avem-labs/Avem/docs/images/FinalVersion.JPG

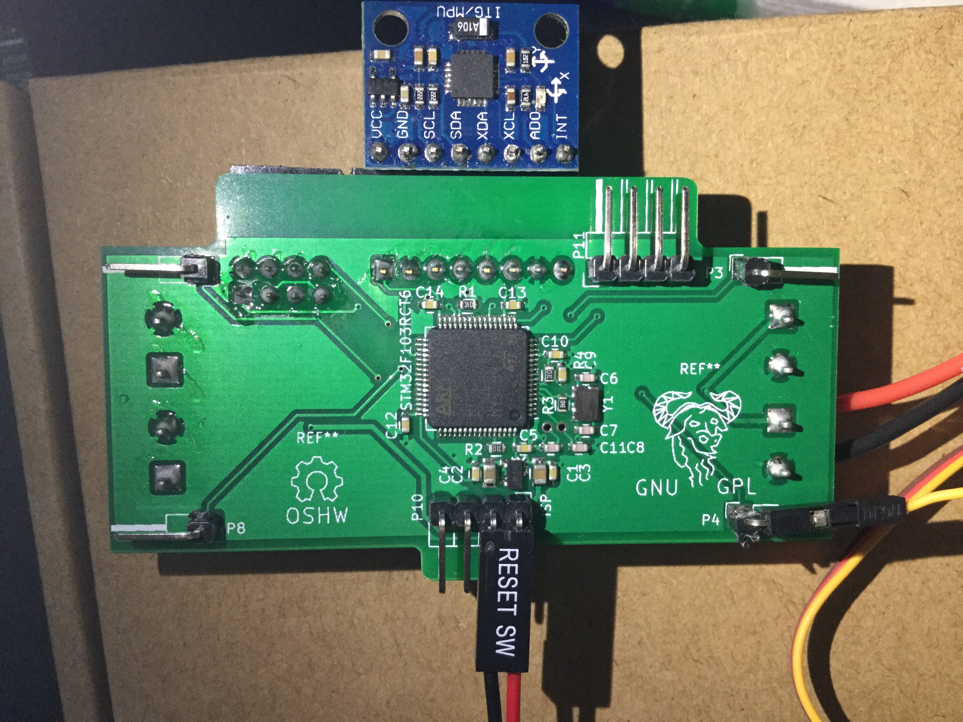
docs/images/FinalVersion.JPG
