avem-labs/Avem/docs/images/PCB/demoV1.0.jpg

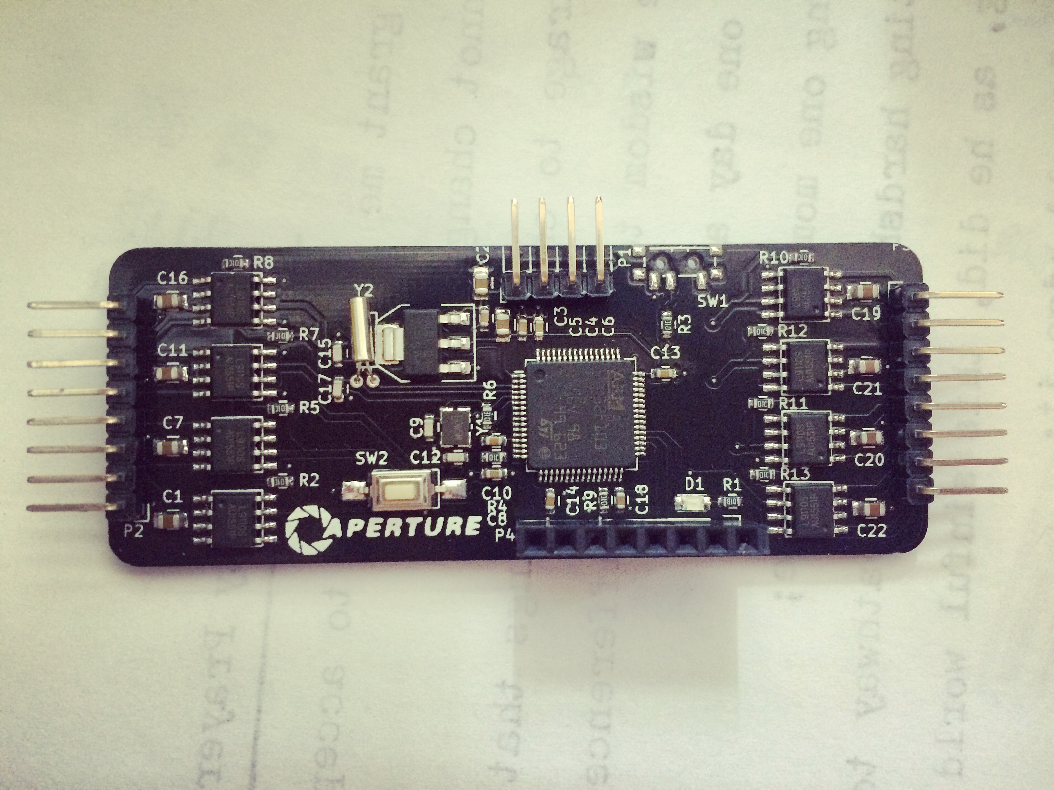
docs/images/PCB/demoV1.0.jpg
