avem-labs/Avem/docs/images/PCB/demoV2.0.JPG

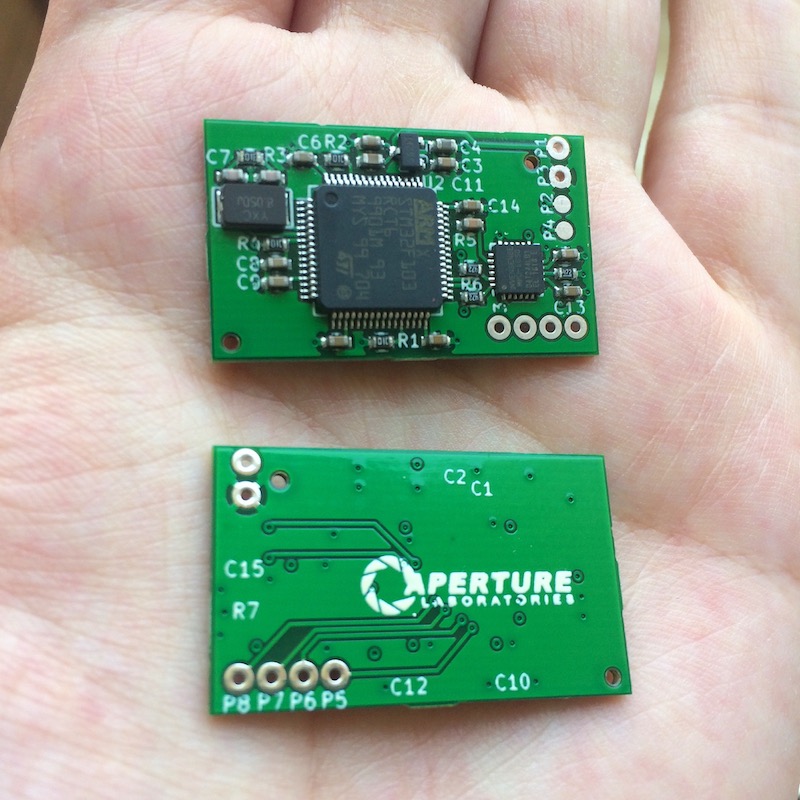
docs/images/PCB/demoV2.0.JPG
