avem-labs/Avem/docs/images/PCB/demoV2.0_PCB.JPG

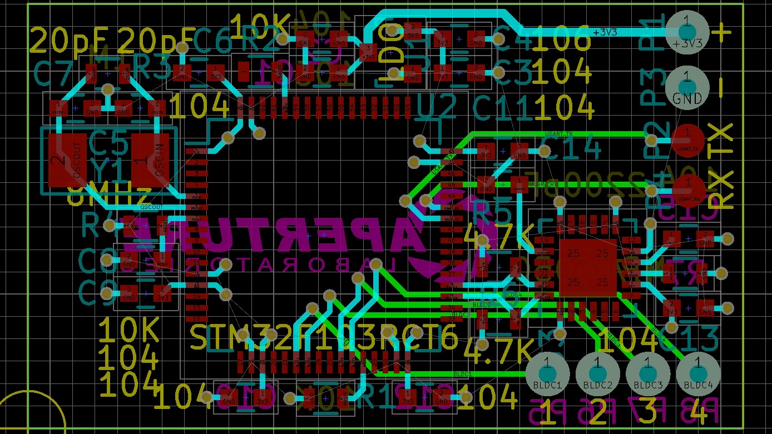
docs/images/PCB/demoV2.0_PCB.JPG
