avem-labs/Avem/docs/images/PCB/demoV2.png

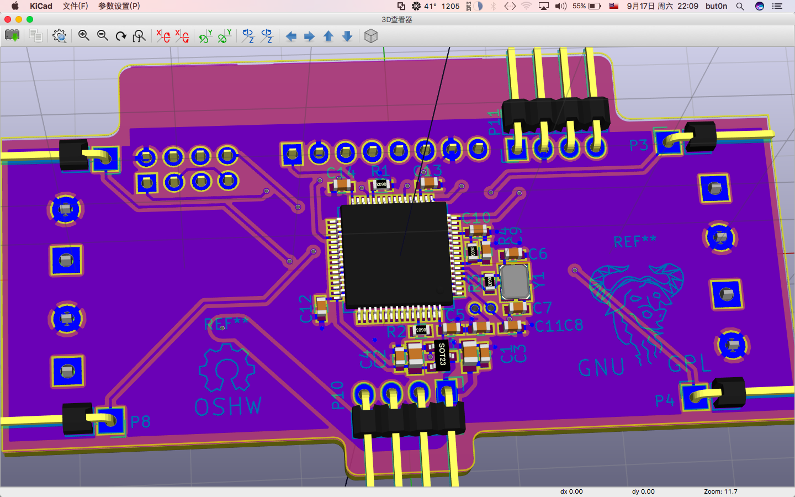
docs/images/PCB/demoV2.png
