avem-labs/Avem/docs/images/PCB/demoV3.0_top.JPG

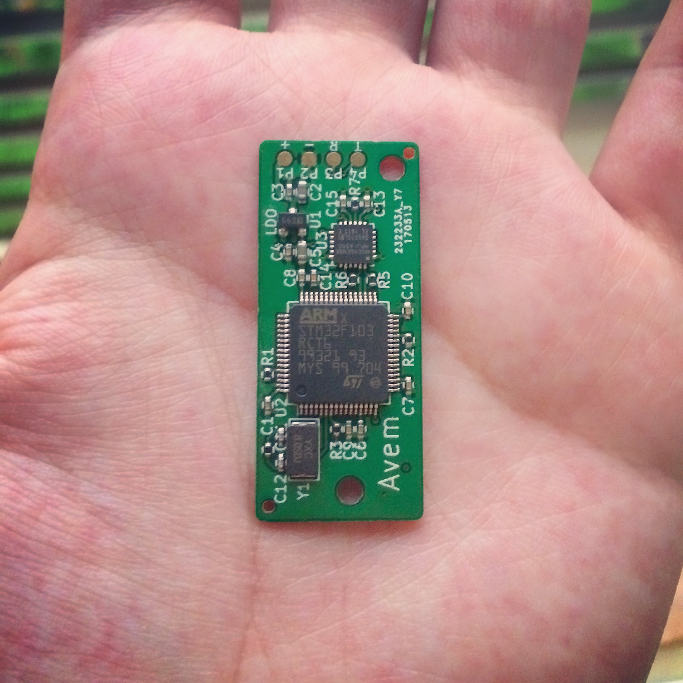
docs/images/PCB/demoV3.0_top.JPG
