avem-labs/Avem/docs/images/PCB/layoutB.png

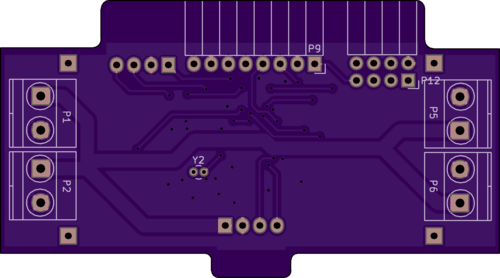
docs/images/PCB/layoutB.png
