avem-labs/Avem/docs/images/PCB/layoutF.png

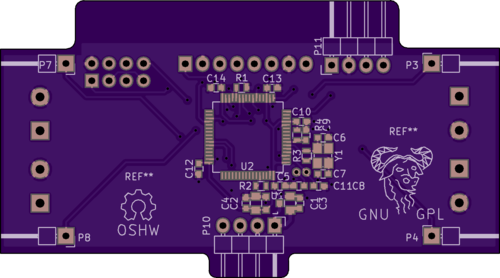
docs/images/PCB/layoutF.png
