avem-labs/Avem/rm_img/PCB/pcb_.png

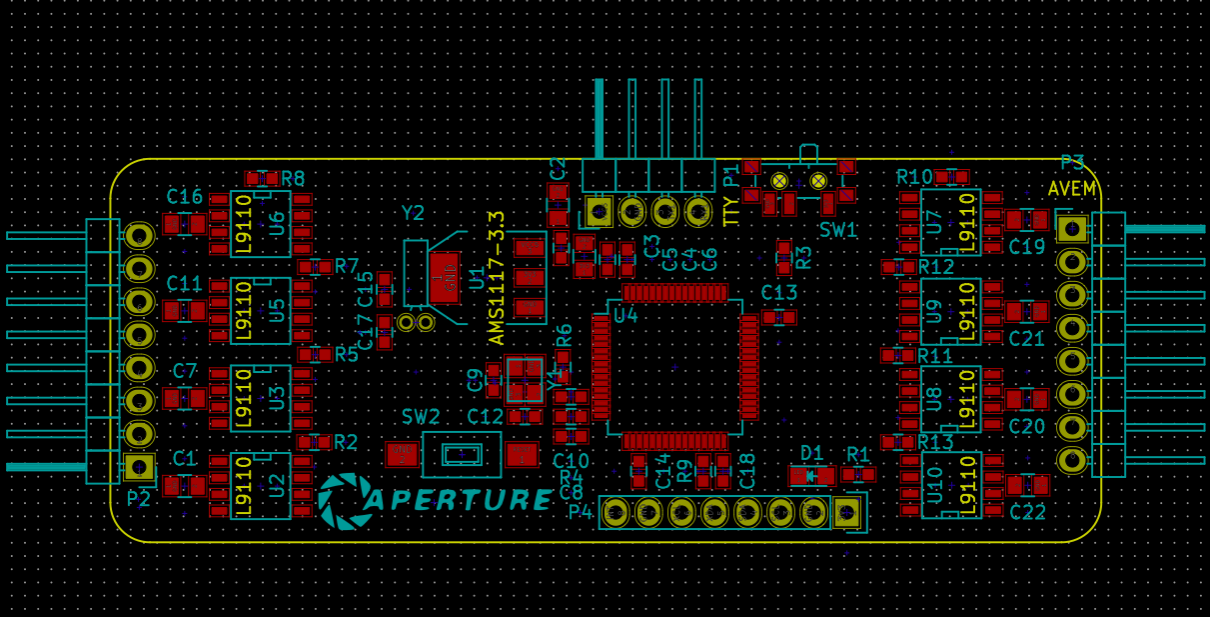
rm_img/PCB/pcb_.png
