avem-labs/Avem/docs/Avem_demoV2.0.pdf

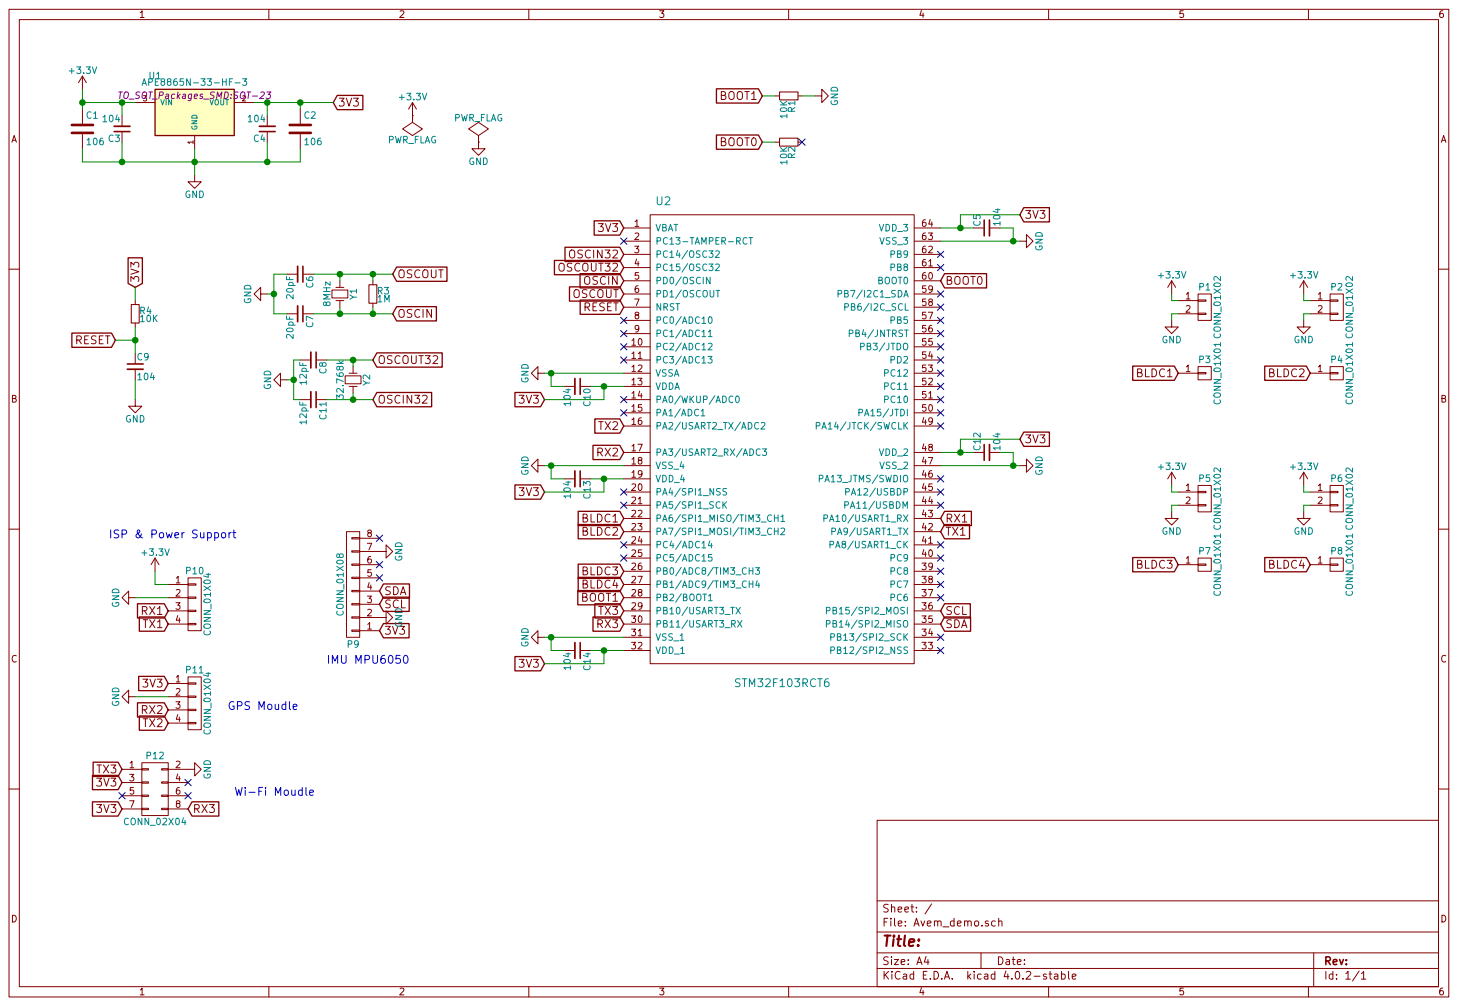
[picture p15: page 1]
