avem-labs/Avem/docs/Avem_UAV.pdf

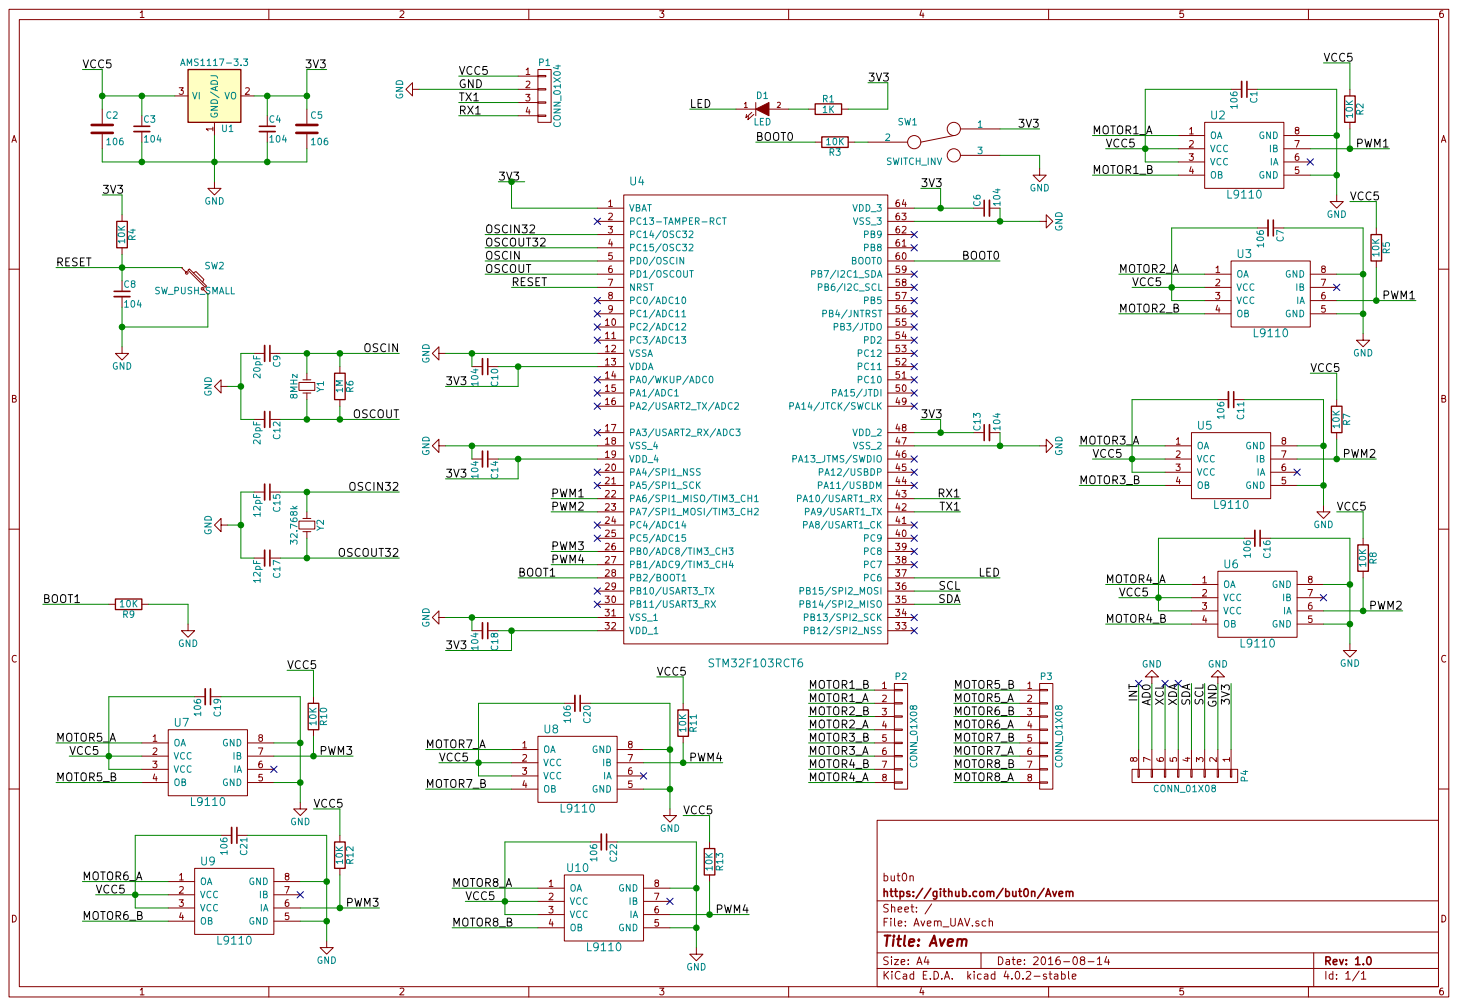
[picture p16: page 1]

but0n
File: Avem_UAV.sch Sheet: / https://github.com/but0n/Avem
