avem-labs/Avem/(commit log)

2016-08-11 Update Schematic
2016-08-11 PCB Layout done:v:
2016-08-11 Update PCB
2016-08-11 Fixed PCB
2016-08-11 Fixed PCB:v:
2016-08-13 PCB 遷移
2016-08-13 Add a Motor on PA6, TIM3 CH2:smirk:
2016-08-13 Change init PWM value
2016-08-14 remove schematic
2016-08-14 Fixed erro:'arm-none-eabi-gcc: not found'
2016-08-14 Fixed Travis arm-gcc
2016-08-14 Add pcb img
2016-08-17 :package:Add :clipboard:Bill of Material
    [bom.csv]
2016-08-17 :package:Uart Component
2016-08-19 Brushless Motor Done:v:
2016-08-20 Brushless motor auto startup:v:
2016-08-22 [Fixed]USART print always lost the first byte
    [main.c]
2016-08-23 ESP8266谜之无应答。。是不是换行和回车顺序问题
2016-09-03 PCB erro
2016-09-03 PCB test
2016-09-07 ADD:PCB Picture
2016-09-08 NEW: Project Framework
2016-09-08 MOD: Add image of project framework
2016-09-12 MOD: I cost a long time to fix the bug of WiFi moudle. and finaly , The bug is about 0x0D and 0x0A timing...(WTF?.jpg)
    [main.c]
2016-09-17 [RM+MOD+ADD]: Redesigned The PCB
2016-09-18 [MOD]: Change the Zone Gap of GND
2016-09-18 [MOD]: I realized I had an erro on my PCB(BLDC Power Track Width), besides, The Gap Of Ground Zone is Not Short Enough
2016-09-24 [ADD&MOD]: Pin Changed and New Image of PCB
2016-09-24 [MOD]: Remove AD0 Pin of MPU6050 port
2016-09-27 [MOD]: Fixed BUG, UART Print short data function
    [main.c]
2016-09-28 [MOD]: 1) Euler Angles Offset Fixed; 2) Motor Setting
    [main.c]
2016-09-30 [MOD]: 4 Channels PWM
2016-10-05 [MOD]: PID test plathform
2016-10-05 [MOD]: 把增量式改为位置式
2016-10-08 [ADD]: Cascade PID Control
2016-10-08 [MOD]: PID
2016-10-08 [MOD]: PID Struct Type Define
2016-10-09 [MOD]: PID Control Codes
2016-10-10 [MOD]: Fixed PID and Rename Struct
2016-10-10 [MOD]: PID Control差不多完成了
2016-10-10 [Fixed]: PWM限幅
2016-10-10 [Fixed]: 强类型转换放错了地方
2016-10-10 [Fixed] 计算输出时没有将float转为short, 虽然编译没有报错
2016-10-10 [MOD]: Add PID Output Console
2016-10-10 强类型转换忘记加括号惹..
2016-10-10 通电后发现两个电机和Roll角度的反馈和预期的相反
2016-10-10 [准备进入调PID环节了...]
2016-10-10 [MOD]: Update PID
2016-10-15 [MOD]: Add Startup Optional: Normal Startup and Throttle Range Setting
2016-11-21 [MOD]: IMPORTANT! Modified Framework of Makefile
2016-11-23 [MOD]: PID link
2016-11-28 [MOD]: Config MPU6050 Pin map to another develop plathform PCB
2016-11-28 [MOD]: FreeRTOS Test Successed! Include two Tasks: Get data from mpu6050 and print data that after transition with uart
2016-11-28 [MOD]: Take the pid struct outside of main function
2016-11-28 [MOD]: Fixed bug, Add #endif
    [main.c]
2016-11-28 [MOD]: Enhancement Uart Print Function, it's simple enough right now
2016-11-28 [MOD]: Add PID Task
2016-11-30 [MOD]: Changed PWM Config, Fixed PID
2016-12-02 [MOD]: Changed the Rate of BLDC from 500Hz to 50Hz, 1ms-LOW, 2ms-HIGH
2016-12-02 [MOD]: Fixed MOTOR_LOW
2016-12-02 [MOD]: Fixed duty cycle of PWM, Normal Startup Success
2016-12-02 [ADD]: Add Detail of Config Argument of PID Control, and Update Codes
2016-12-02 [FIX]: before install
    [openjtag.cfg, stm32f1x.cfg]
2016-12-10 [MOD]: Clean Folders
    [bom.csv]
2016-12-18 style:(uart) A little bit enhancement
2016-12-20 fix: Clear Screen of terminal
    [main.c]
2016-12-23 feat: (ISP) Program with STM32 built-in USB DFU Bootloader
2016-12-23 feat: led test
2017-02-15 refactor:(makefile tty)
    [bom.csv]
2017-03-29 style: (readme) Try to fix syntax error, wired layout
2017-04-04 feat: Handle Serial Interrupt
2017-04-05 feat: decode function of UART Interrupt
2017-04-16 style: (uart_showData) Use array to stored the bit values, that will be a little bit enhancements
2017-04-30 doc: (pcb) New Version
2017-05-20 doc: (images) PCB V3.0
2017-05-26 feat: (debug) Error Feedback
    [main.c]
2017-09-19 Test: prefab PID
2018-01-28 fix: (jump2ISP) reset timer before jump
